JHurricane96/mazegame/(commit log)

2016-03-13 Add battle mode framework
2016-05-05 Add arduino code to its directory to satisfy Arduino IDE
